carlymx/SIMON.ino-Shield/imgs/by-nc-sa.png

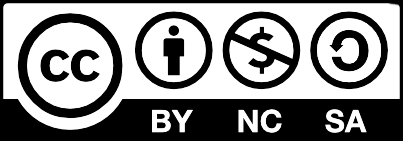
imgs/by-nc-sa.png
