carlymx/SIMON.ino-Shield/imgs/photos/v1.0.2/20191204_123447.jpg

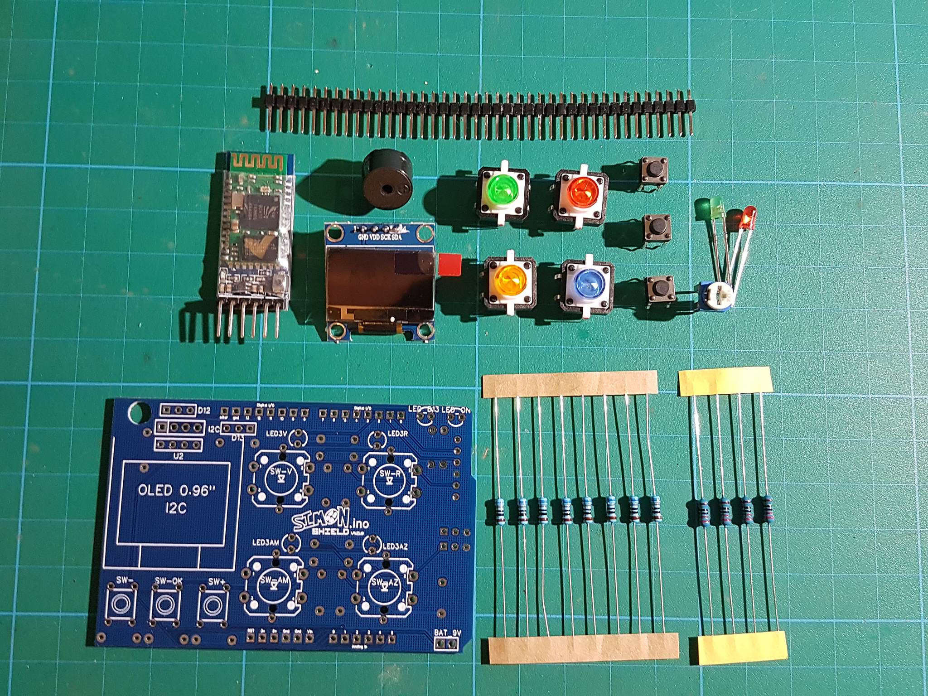
imgs/photos/v1.0.2/20191204_123447.jpg
