carlymx/SIMON.ino-Shield/imgs/photos/v1.0.2/20191204_133109.jpg

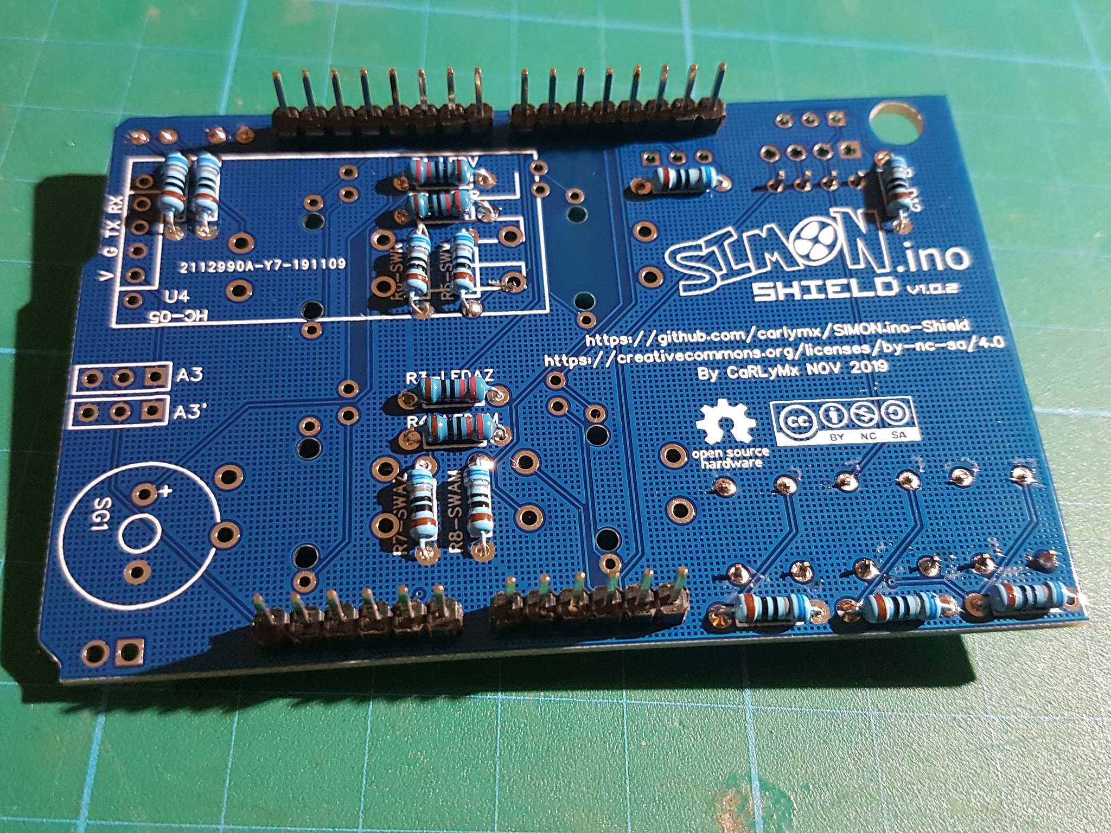
imgs/photos/v1.0.2/20191204_133109.jpg
