carlymx/SIMON.ino-Shield/imgs/photos/v1.0.2/20191205_111353.jpg

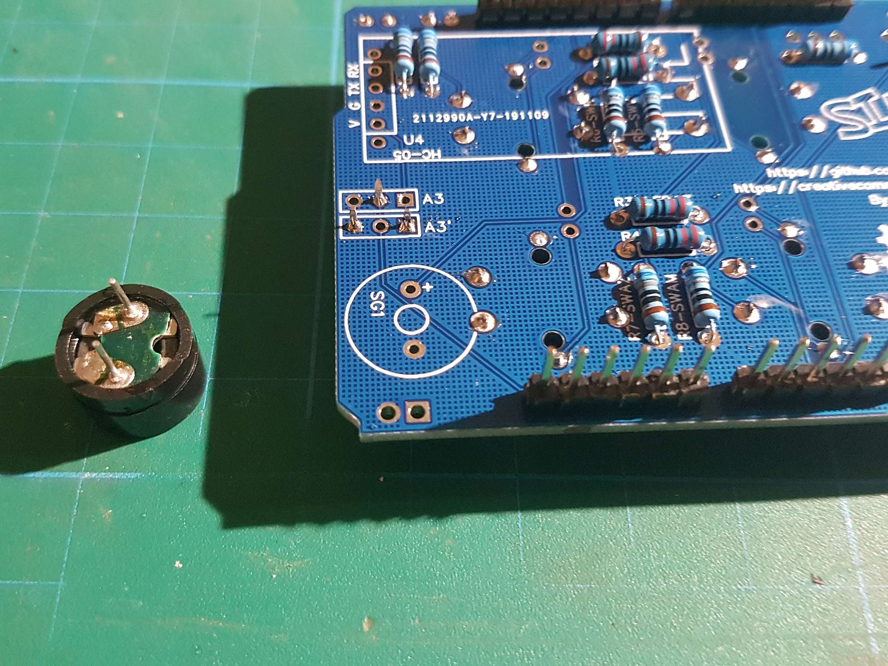
imgs/photos/v1.0.2/20191205_111353.jpg
