carlymx/SIMON.ino-Shield/imgs/photos/v1.0.2/20191205_112857.jpg

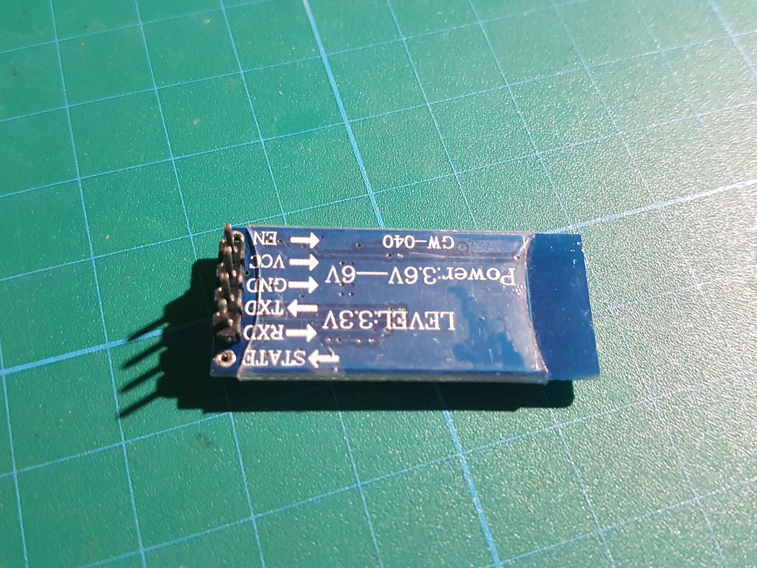
imgs/photos/v1.0.2/20191205_112857.jpg
