carlymx/SIMON.ino-Shield/imgs/photos/v1.0.2/20191205_114523.jpg

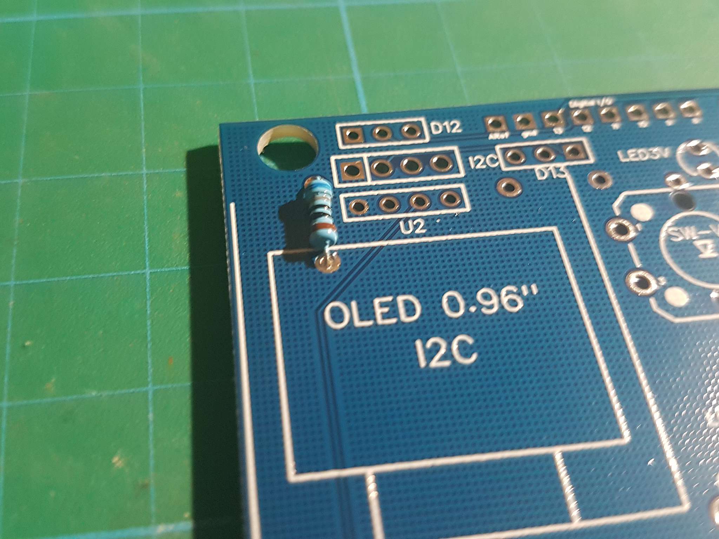
imgs/photos/v1.0.2/20191205_114523.jpg
