carlymx/SIMON.ino-Shield/imgs/SIMON.ino-Shield_TinKerCad_Mod.png

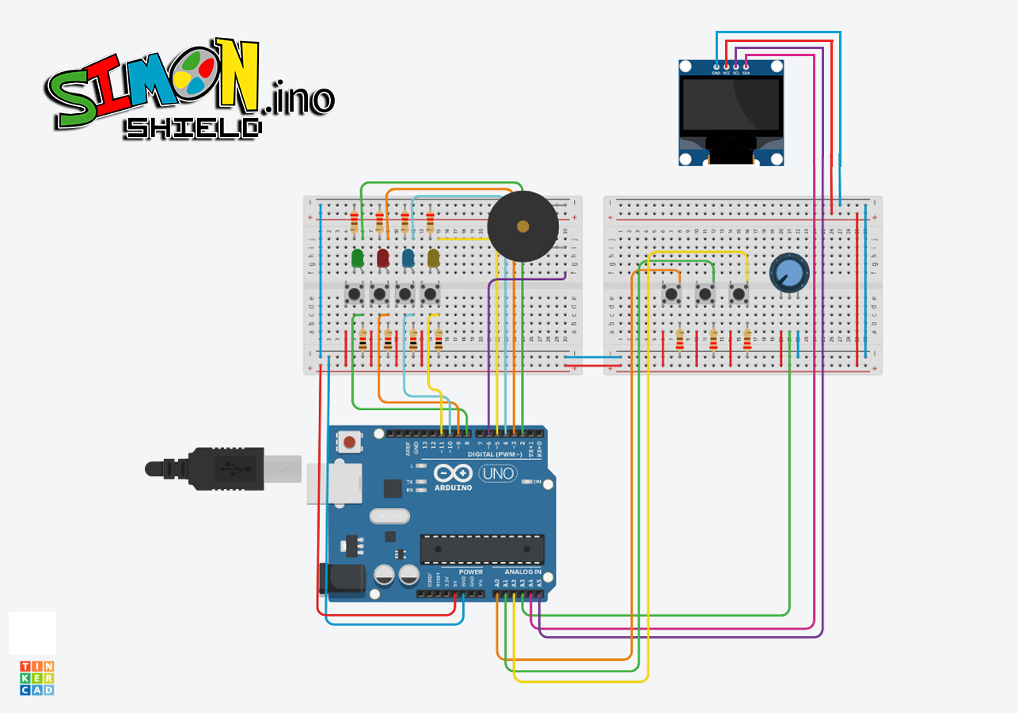
imgs/SIMON.ino-Shield_TinKerCad_Mod.png
