carlymx/SIMON.ino-Shield/PCB_Shield/v1.0.3/BOM/BOM_SIMON.ino Shield_v103.csv

ID | Name | Designator | Footprint | Quantity | URL
1 | ARDUINO | UNO U1 ARDUINO UNO 1 https://es.aliexpress.com/item/32985374826.html?s=p
2 | 204-10SURD/S530-A3 | LED3V,LED3R,LED3AZ,LED3AM,LED_ON | LED-3MM/2.54 | 5 | https://es.aliexpress.com/item/32847084816.html?s=p
3 | SWITCH-MOMENTARY-LED | SW-V,SW-R,SW-AZ,SW-AM | TACTILE-PTH-LED-12MM | 4 | https://es.aliexpress.com/item/32825221825.html?spm=a2g0s.9042311.0.0.76be63c0ipVcch
4 | Header-Male-2.54_1x2 | BAT_9V | HDR-2X1/2.54 | 1 | https://es.aliexpress.com/item/32724478308.html
5 | BUZZER | SG1 | BUZZER-12MM-NS-KIT | 1 | https://es.aliexpress.com/item/32762426798.html?spm=a2g0s.9042311.0.0.5e4863c0sMzHNQ
6 | R220 | RESISTENCIA | AXIAL-0.3 | 4 | https://es.aliexpress.com/item/32847096736.html?s=p
7 | R680 | RESISTENCIA | AXIAL-0.3 | 11 | https://es.aliexpress.com/item/32847096736.html?s=p
8 | HC-05 | U4 | HC-05 | 1 | https://es.aliexpress.com/item/4000144439510.html?s=p
9 | SWITCH-6x6x5_TH | SW+,SW-,SW-OK | SWITCH-6X6X5_TH | 3 | https://es.aliexpress.com/item/32856220123.html
10 | LCD | OLED | 0.96 | 1 | https://es.aliexpress.com/item/32638662748.html
11 | Header-Female-2.54_1x3 | D12,A3 | HDR-3X1/2.54 | 2 | https://es.aliexpress.com/item/32724478308.html
12 | Header-Male-2.54_1x4 | I2C Connector | DIP-1X4P-2.54MM-M | 1 | https://es.aliexpress.com/item/32724478308.html
