carlymx/SIMON.ino-Shield/PCB_Shield/v1.0.3/Schematic 1.0.3/Schematic_SIMON.ino Shield_SIMON.ino Shield v1.0.3_20191209120610.pdf

A | A

1

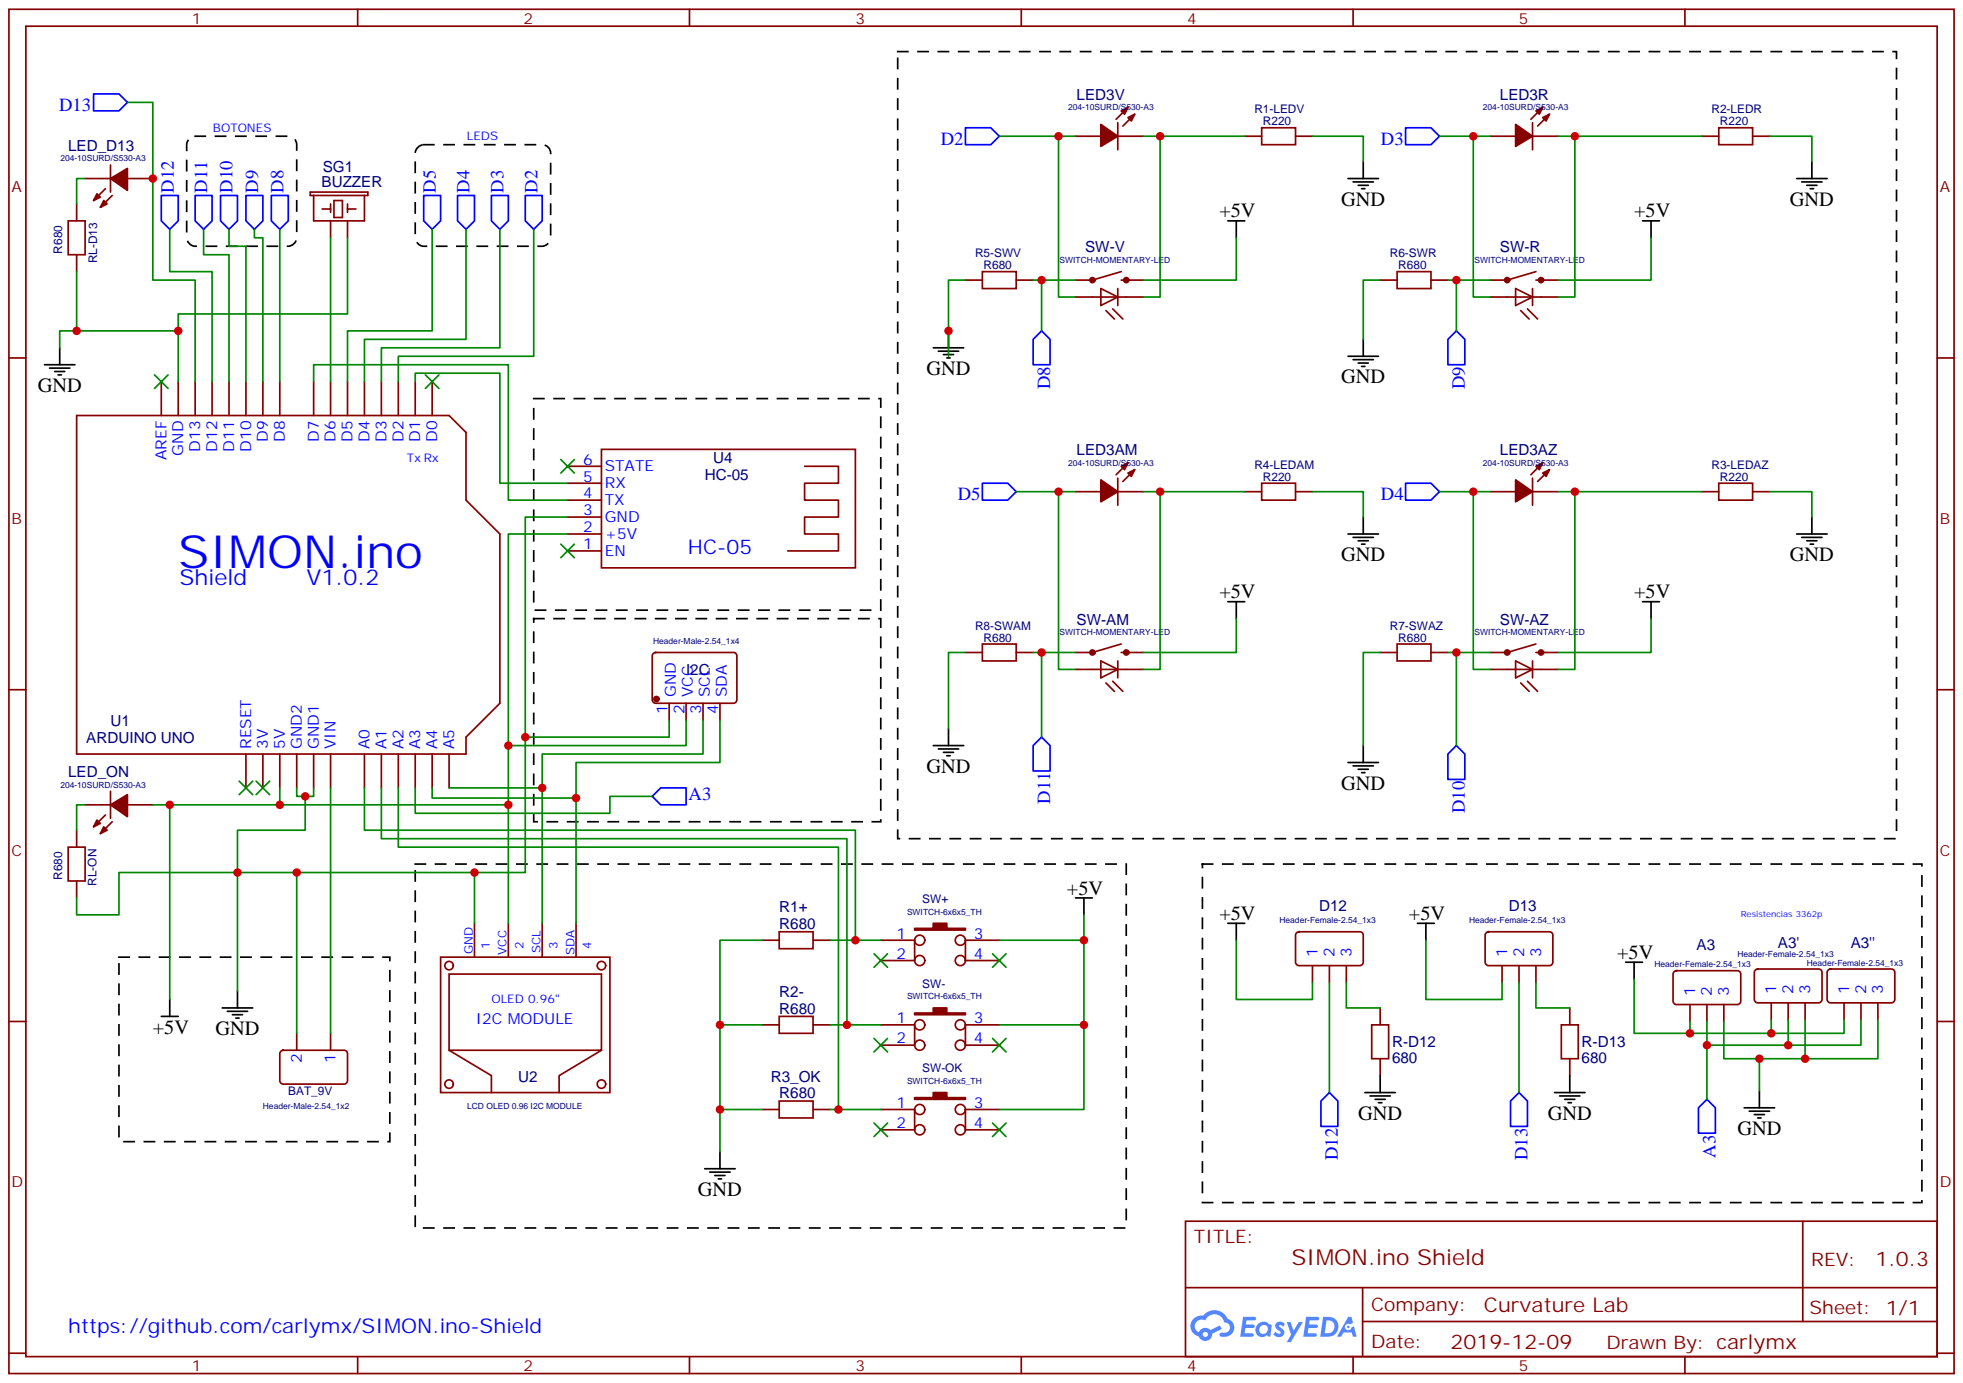
[picture p27: page 1]

https://github.com/carlymx/SIMON.ino-Shield
