carlymx/SIMON.ino-Shield/PCB_Shield/v1.0.2/Schematic 1.0.2/Schematic_SIMON.ino Shield_SIMON.ino Shield v1.0.2_20191108122940.pdf

A | A

1

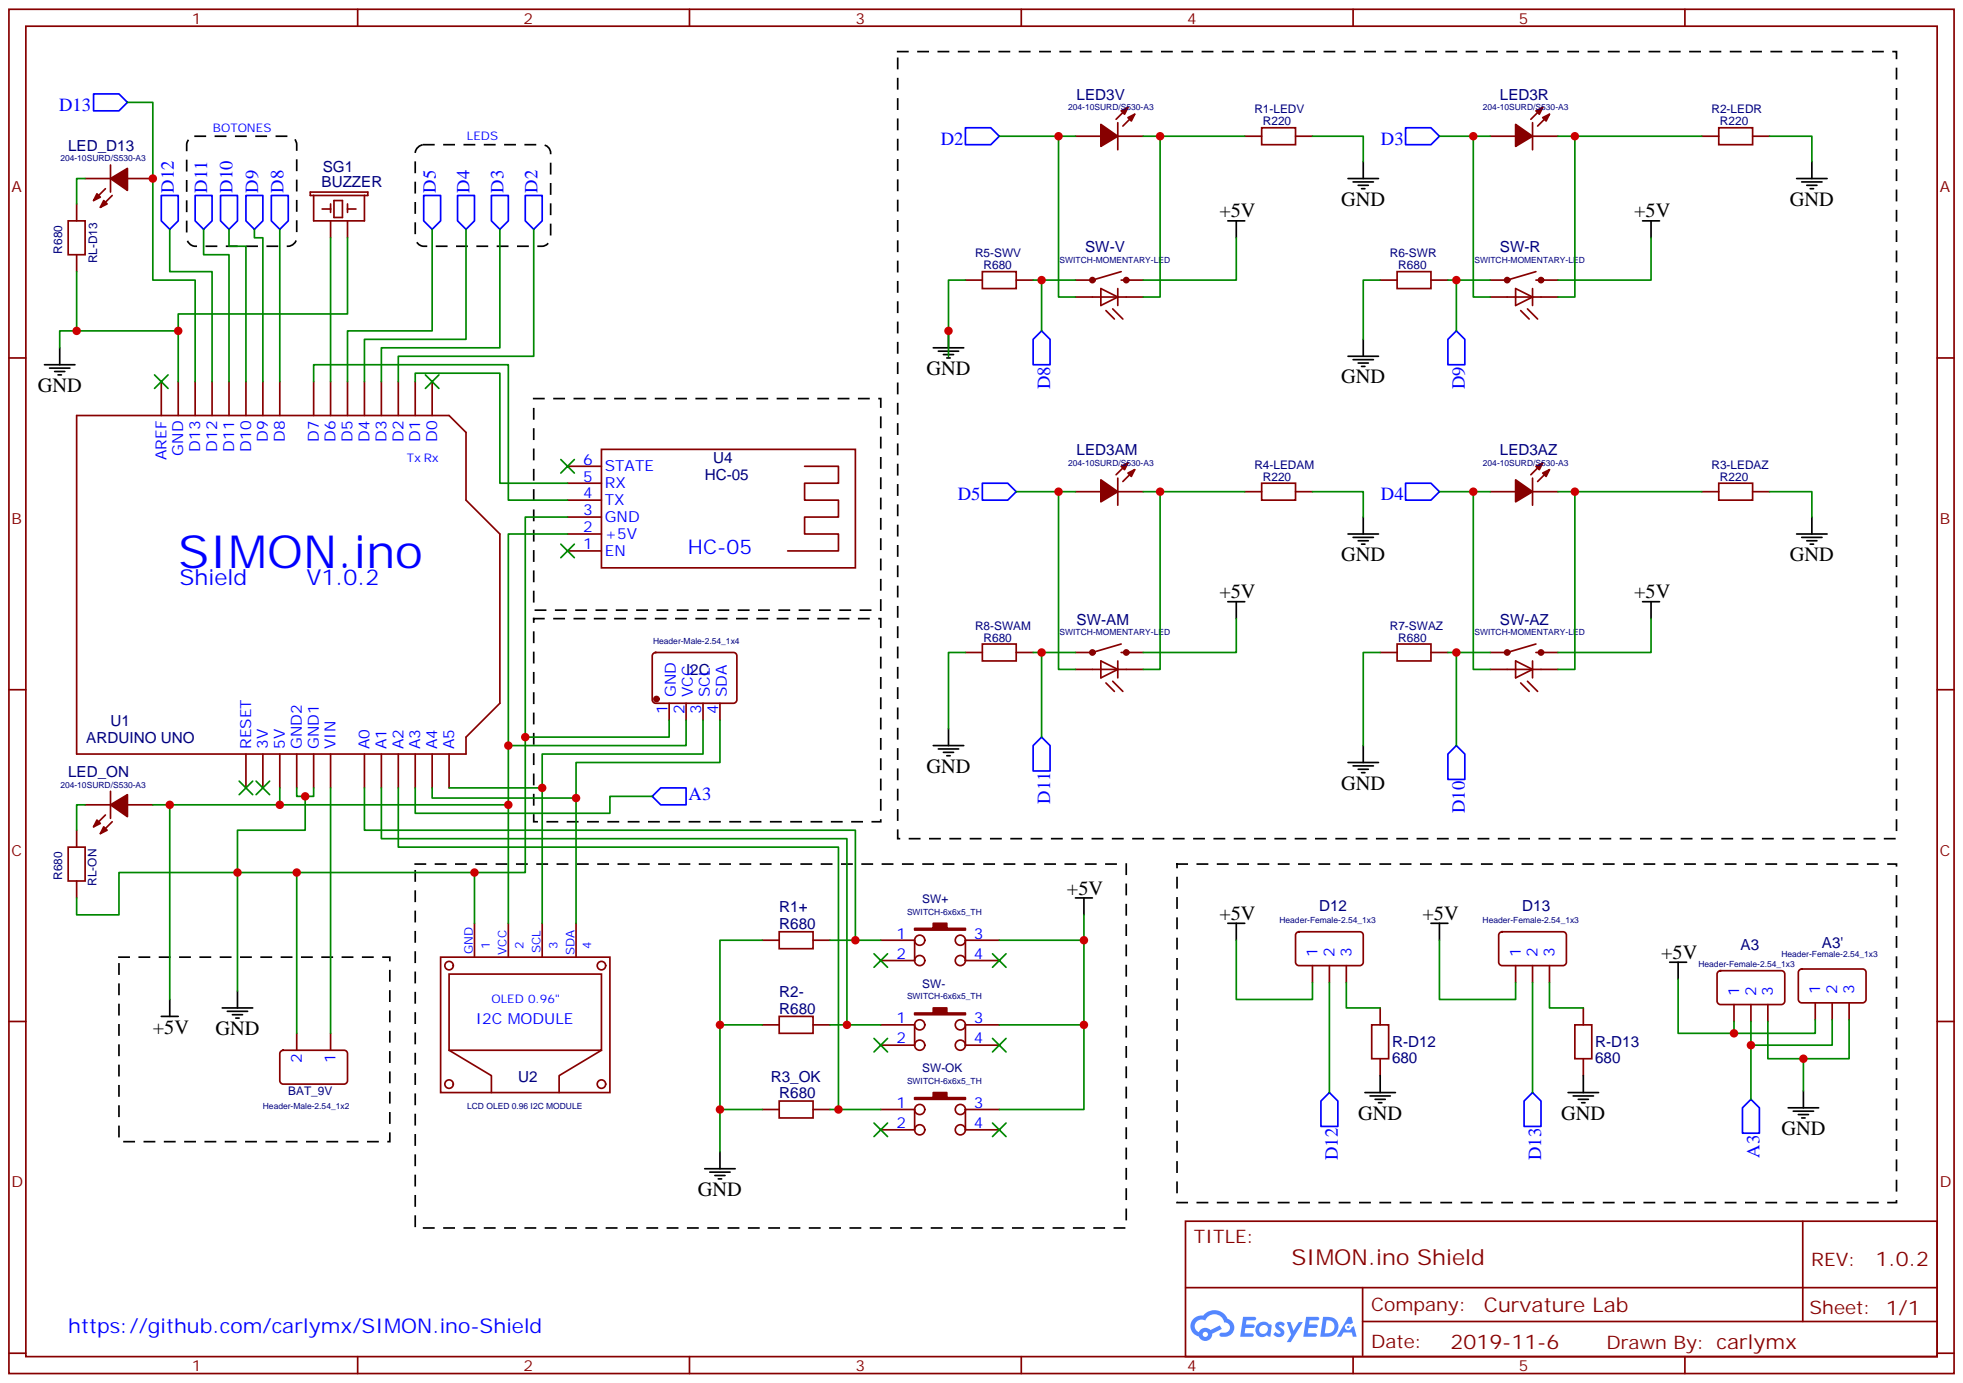
[picture p29: page 1]

https://github.com/carlymx/SIMON.ino-Shield
