carlymx/SIMON.ino-Shield/PCB_Shield/legacy/v1.0.0/Schematic 1.0.0/Schematic_SIMON.ino Shield_SIMON.ino Shield v0.1a_20191001130017.pdf

A | A

1

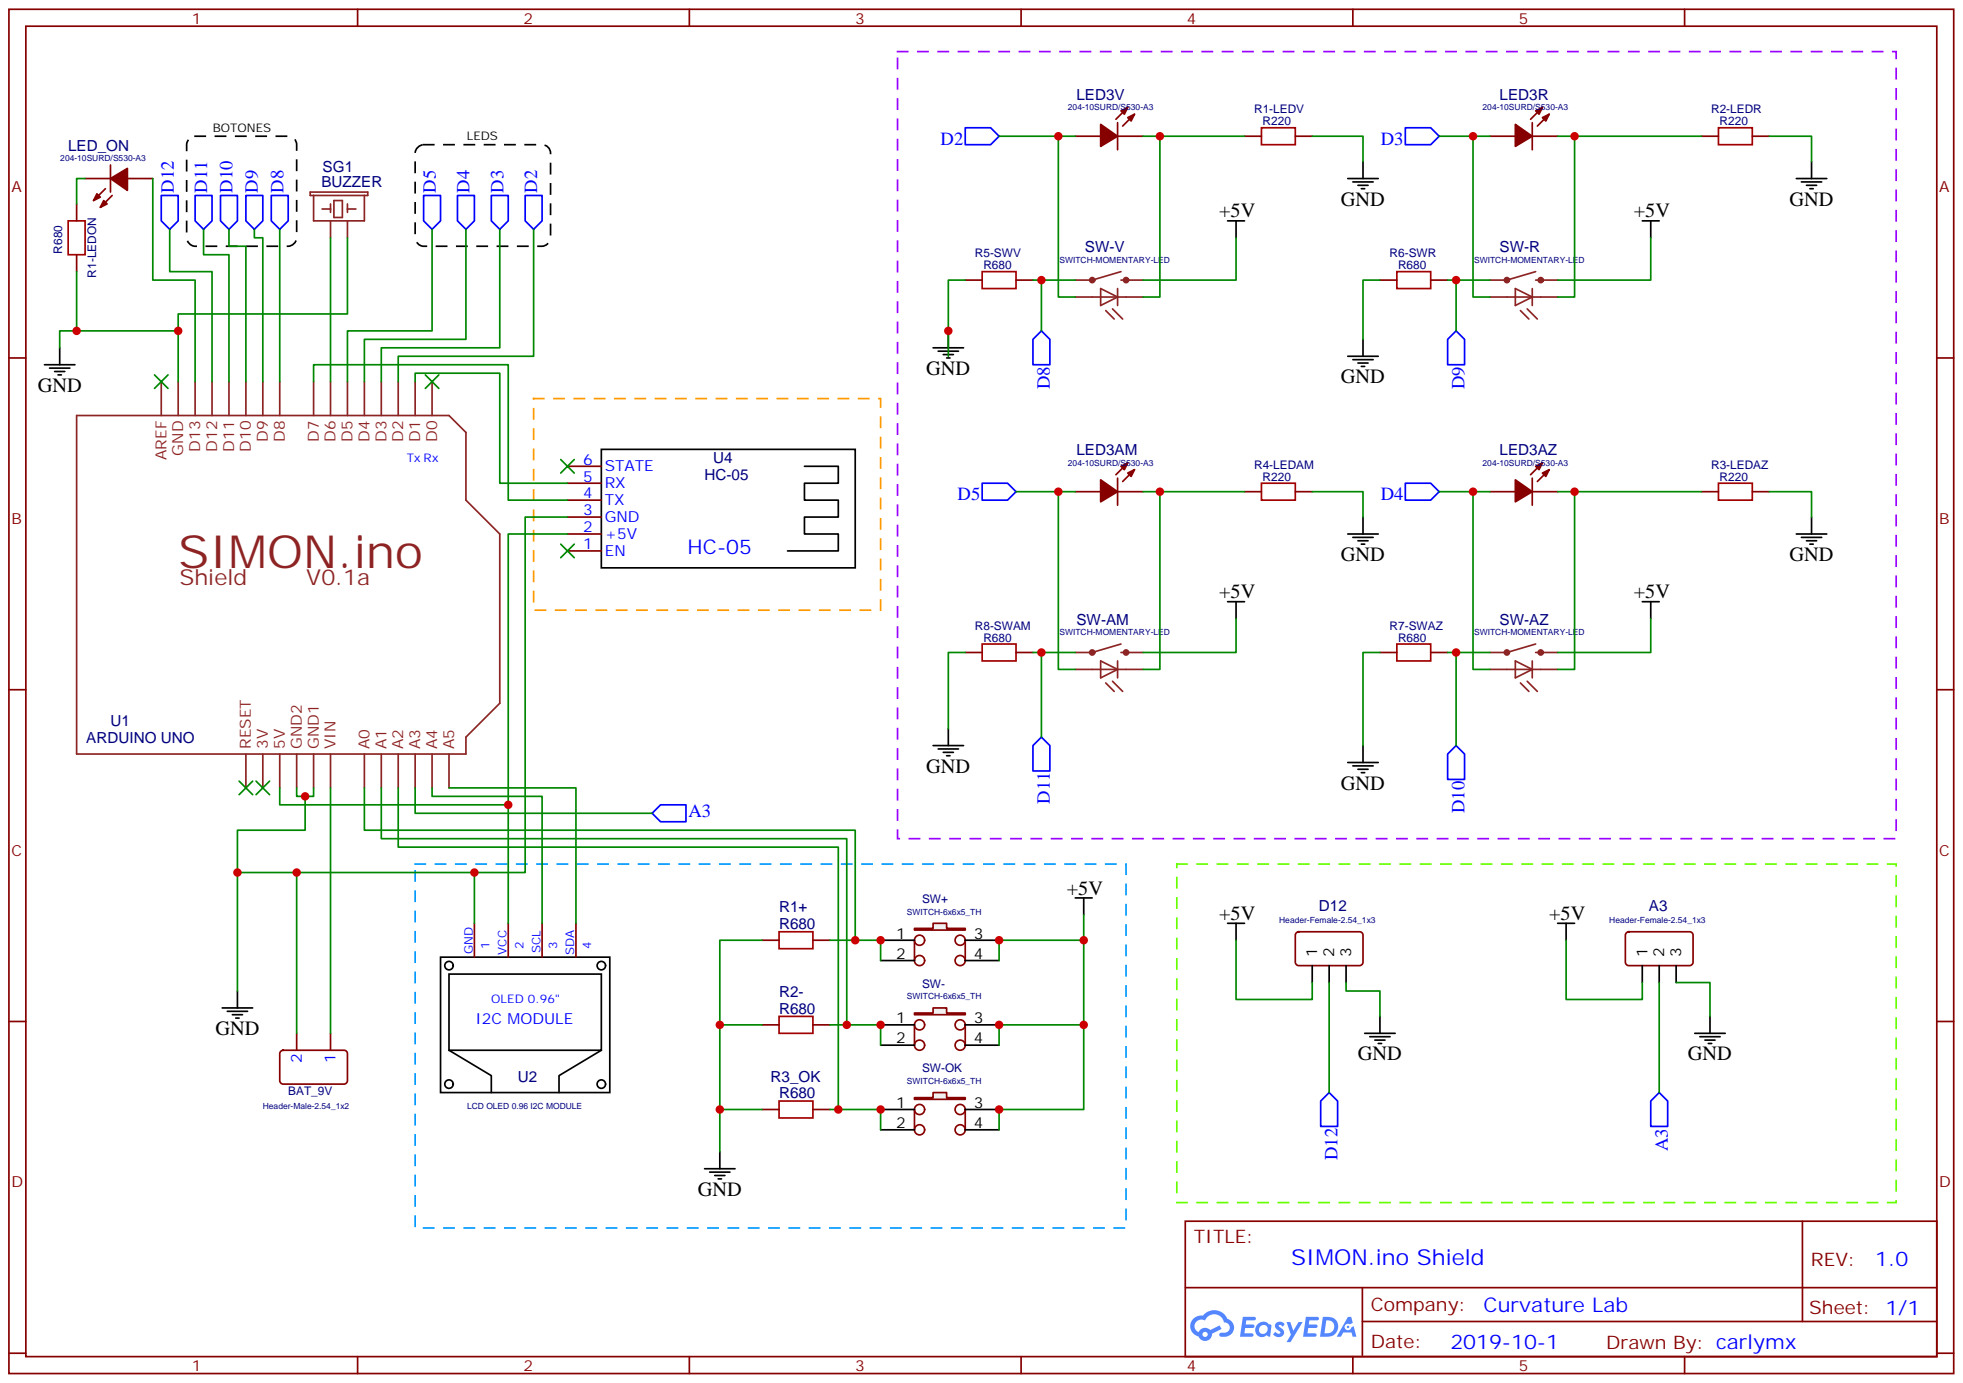
[picture p30: page 1]
