carlymx/SIMON.ino-Shield/PCB_Shield/legacy/v1.0.1/Schematic 1.0.1/Schematic_SIMON.ino Shield_SIMON.ino Shield v1.0.1_20191002000535.pdf

A | A

1

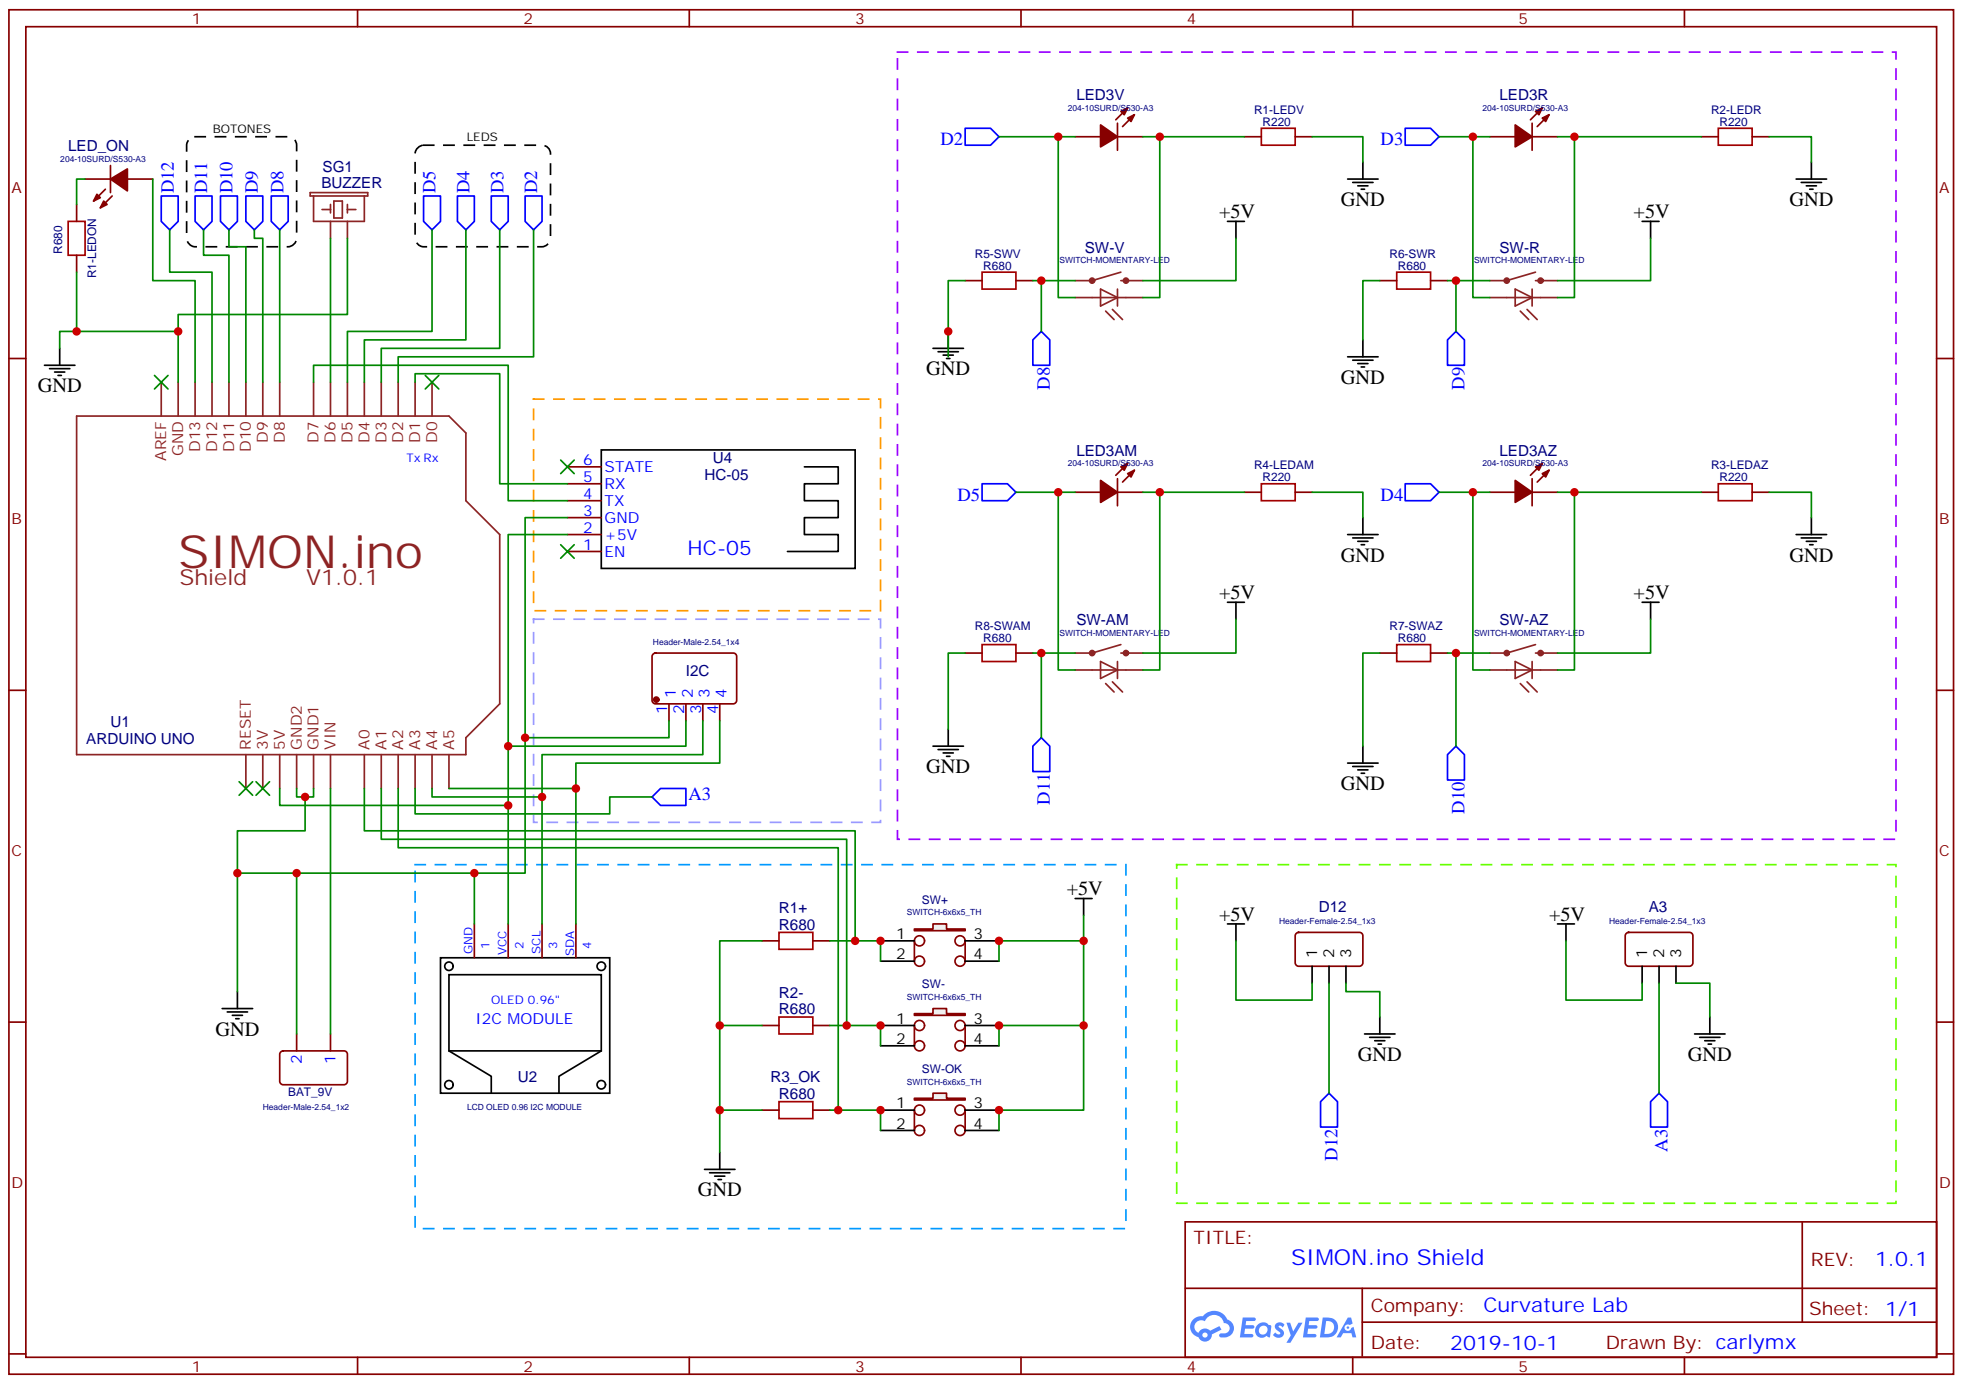
[picture p31: page 1]
