carlymx/SIMON.ino-Shield/(commit log)

2019-11-04 Upload Project Parts
    [BOM_SIMON.ino Shield_20191002000940.csv]
2019-11-05 New Version PCB v1.0.2
    [BOM_SIMON.ino Shield_20191105231931.csv]
2019-11-05 Update PCB v1.0.2
    [BOM_SIMON.ino Shield_20191002000940.csv]
2019-11-08 Upgrade PCB and files.
    [BOM_SIMON.ino Shield_20191105231931.csv, BOM_SIMON.ino Shield_20191108123017.csv]
2019-12-07 Upgrade and FIX PCB:1.0.3
2019-12-07 Upload photos PCB v1.0.2
2019-12-07 Upload BOM
    [BOM_SIMON.ino Shield_v103.csv, BOM_SIMON.ino Shield_v103.ods, BOM_SIMON.ino Shield_v103.xls]
2019-12-16 Update BOM_SIMON.ino Shield_v103.csv
    It was missing a designator in order to be processed as a table
    [BOM_SIMON.ino Shield_v103.csv]
2019-12-17 Añadida primera version de Simon
2019-12-17 Añadida contador de pulsaciones
